asaju67/POV-Sphere-Display/(commit log)

2026-04-21 Initial commit: Arduino POV Display project with SD card sprite loading and timer mode
2026-04-22 more correct timer error in web ui if sprite file missing
    [app_state.h, timer_mode.cpp]
2026-04-29 hall sensor working and showing state in serial moniter
2026-07-10 Add README.md with project details and instructions
    Added detailed project description, features, system overview, hardware design, manufacturing instructions, firmware details, web interface setup, display format, hall sensor synchronization, ESP32 pin assignments, software dependencies, documentation, current limitations, and future improvements.
